zeabusTeam/power_management/circuit/power_distributor.kicad_pcb

## KiCad design circuit/power_distributor.kicad_pcb (2020-04-21)

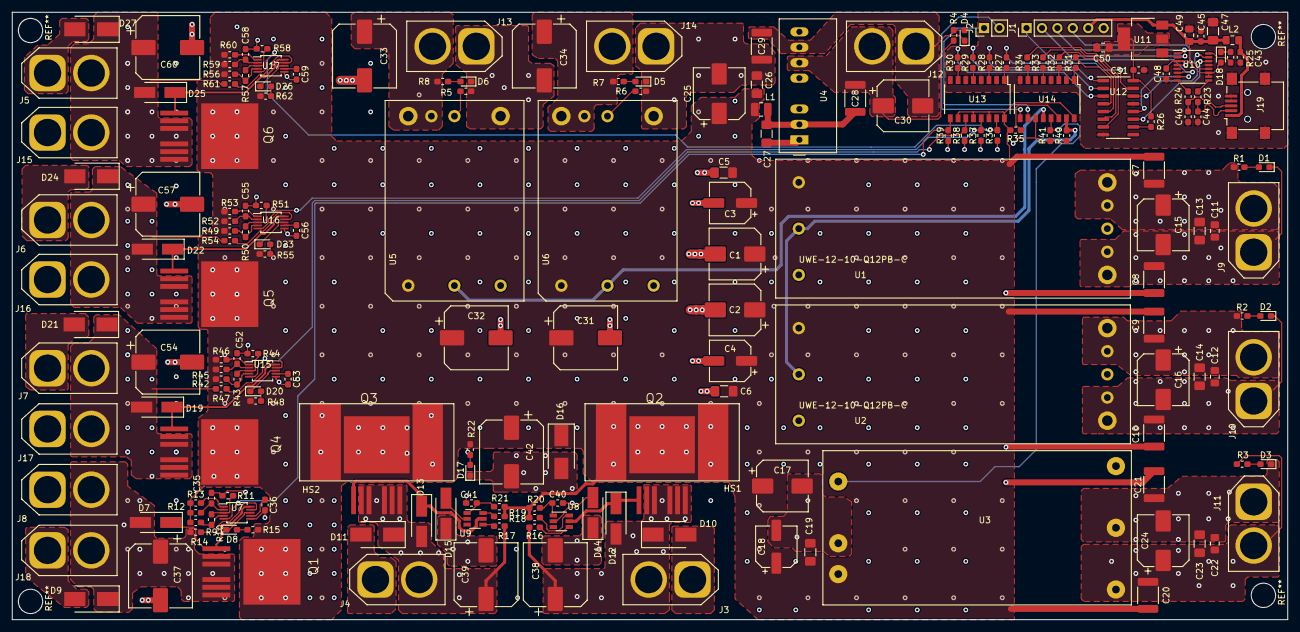
[picture p13: board power_distributor.kicad_pcb from above]

Board: 4 copper layers, 210.0 x 100.0 mm, 195 parts (0 on the bottom side), 119 nets.

Parts:
C1, C2, C15, C16, C17, C24, C25, C30: 100uF; CP_Elec_8x10
C3, C4, C18: 22uF; CP_Elec_6.3x5.8
C5, C6, C13, C14, C19, C23, C26, C27: 10uF; C_1206_3216Metric_Pad1.42x1.75mm_HandSolder
C7, C8, C9, C10, C20, C21, C28, C29: 1000pF,3kV; C_1812_4532Metric_Pad1.30x3.40mm_HandSolder
C11, C12, C22, C49, C50: 1uF; C_0805_2012Metric_Pad1.15x1.40mm_HandSolder
C31, C32, C33, C34, C37, C38, C39, C42, C54, C57, C60: 220uF; CP_Elec_10x10
C35, C40, C41, C45, C48, C51, C52, C55, C58: 0.1uF; C_0603_1608Metric_Pad1.05x0.95mm_HandSolder
C36, C53, C56, C59: 150nF; C_0603_1608Metric_Pad1.05x0.95mm_HandSolder
C43: 0.01uF; C_0603_1608Metric_Pad1.05x0.95mm_HandSolder
C44, C46: 47pF; C_0603_1608Metric_Pad1.05x0.95mm_HandSolder
C47: 4.7uF; C_1206_3216Metric_Pad1.42x1.75mm_HandSolder
D1: 12V_On_1; LED_0603_1608Metric_Pad1.05x0.95mm_HandSolder
D2: 12V_On_2; LED_0603_1608Metric_Pad1.05x0.95mm_HandSolder
D3: 5V_On; LED_0603_1608Metric_Pad1.05x0.95mm_HandSolder
D4: 24V_On; LED_0603_1608Metric_Pad1.05x0.95mm_HandSolder
D5: 8.4V On_2; LED_0603_1608Metric_Pad1.05x0.95mm_HandSolder
D6: 8.4V On_1; LED_0603_1608Metric_Pad1.05x0.95mm_HandSolder
D7, D12, D13, D19, D22, D25: SMAJ17CA; D_SMA_Handsoldering
D8, D20, D23, D26: Thruster_ON; LED_0603_1608Metric_Pad1.05x0.95mm_HandSolder
D9, D10, D11, D16, D21, D24, D27: SMBJ26A; D_SMB_Handsoldering
D14, D15: SS16T3G; D_SMA_Handsoldering
D17: Main On; LED_0603_1608Metric_Pad1.05x0.95mm_HandSolder
D18: USB_On; LED_0603_1608Metric_Pad1.05x0.95mm_HandSolder
HS1, HS2: DA-T263-101E; HeatSink-DA-T263-101E
J1: UART; PinHeader_1x06_P2.54mm_Vertical
J2: Opto_AUX; PinHeader_1x02_P2.54mm_Vertical
J3, J4, J5, J6, J7, J8, J9, J10, J11, J12, J13, J14, J15, J16, J17, J18: AMASS XT60; AMASS_XT60-F_1x02_P7.20mm_Vertical
J19: USB_B_Mini; USB_Mini-B_Lumberg_2486_01_Horizontal
L1: 10uH,1A; L_1008_2520Metric
L2: Ferrite 600R 2A; L_0805_2012Metric_Pad1.15x1.40mm_HandSolder
Q1, Q4, Q5, Q6: AUIRFS8409-7P; D2PAK-7
Q2: IPB009N03LG; D2PAK-7
Q3: IPB009N03L_G; D2PAK-7
R1, R2: 3.6k; R_0603_1608Metric_Pad1.05x0.95mm_HandSolder
R3, R35: 1k; R_0603_1608Metric_Pad1.05x0.95mm_HandSolder
R4: 7.5k; R_0603_1608Metric_Pad1.05x0.95mm_HandSolder
R5, R6, R36, R37, R38, R39, R40, R41: 3.3k; R_0603_1608Metric_Pad1.05x0.95mm_HandSolder
R7, R8: 2.4k; R_0603_1608Metric_Pad1.05x0.95mm_HandSolder
R9, R14, R15, R26, R42, R47, R48, R49, R54, R55, R56, R61, R62: 10k; R_0603_1608Metric_Pad1.05x0.95mm_HandSolder
R10, R43, R50, R57: 160; R_0603_1608Metric_Pad1.05x0.95mm_HandSolder
R11, R44, R51, R58: 1.27k; R_0603_1608Metric_Pad1.05x0.95mm_HandSolder
R12, R20, R21, R45, R52, R59: 100; R_0603_1608Metric_Pad1.05x0.95mm_HandSolder
R13, R46, R53, R60: 8.66k; R_0603_1608Metric_Pad1.05x0.95mm_HandSolder
R16, R17, R18, R19: 0; R_0603_1608Metric_Pad1.05x0.95mm_HandSolder
R22: 5.6k; R_0603_1608Metric_Pad1.05x0.95mm_HandSolder
R23, R24: 27; R_0603_1608Metric_Pad1.05x0.95mm_HandSolder
R25: 270; R_0603_1608Metric_Pad1.05x0.95mm_HandSolder
R27, R28, R29, R30, R31, R32, R33: 200; R_0603_1608Metric_Pad1.05x0.95mm_HandSolder
R34: 220; R_0603_1608Metric_Pad1.05x0.95mm_HandSolder
U1, U2: UWE-12-10-Q12PB-C; UWE-xxxx
U3: UEI30-050-Q12P-C; UEI30
U4: TMR_6-2415WI; Converter_DCDC_TRACO_TMR-xxxx_THT
U5, U6: i6A4W020A033V-001-R; I6A
U7, U15, U16, U17: LM5060; MSOP-10_3x3mm_P0.5mm
U8, U9: LM5050-1; TSOT-23-6
U10: FT230XS; SSOP-16_3.9x4.9mm_P0.635mm
U11: LM1117-3.3; SOT-223-3_TabPin2
U12: 74AHC595D; SOIC-16_3.9x9.9mm_P1.27mm
U13, U14: PS2801C-4; SOP-16_4.4x10.4mm_P1.27mm

Connections:
/Battery_ORing/+BATT: C1.1, C2.1, C3.1, C4.1, C5.1, C6.1, C7.2, C9.2, C17.1, C18.1, C19.1, C20.2, C25.1, C26.1, C31.1, C32.1, C42.1, D16.1, HS1.1, HS2.1, L1.1, Q1.D, Q2.D, Q3.D, Q4.D, Q5.D, Q6.D, R9.1, R12.1, R13.1, R15.1, R18.1, R19.1, R20.1, R21.1, R22.1, R35.2, R42.1, R45.1, R46.1, R48.1, R49.1, R52.1, R53.1, R55.1, R56.1, R59.1, R60.1, R62.1, U1.1, U2.1, U3.1, U5.1, U6.1, U13.10, U13.12, U13.14, U13.16, U14.16
/Battery_ORing/+BATT_1: C38.1, D10.1, D12.2, J3.2, Q2.S, R16.1
/Battery_ORing/+BATT_2: C39.1, D11.1, D13.2, J4.2, Q3.S, R17.1
/DC/DC_conveters/+5V_ISOLATED: C20.1, C22.1, C23.1, C24.1, J11.2, R3.1, U3.4
/DC/DC_conveters/+8.4V_1: C33.1, J13.2, R8.1, U5.7, U5.8
/DC/DC_conveters/+8.4V_2: C34.1, J14.2, R7.1, U6.7, U6.8
/DC/DC_conveters/+12V_ISOLATED_1: C7.1, C11.1, C13.1, C15.1, J9.2, R1.1, U1.7, U1.8
/DC/DC_conveters/+12V_ISOLATED_2: C9.1, C12.1, C14.1, C16.1, J10.2, R2.1, U2.7, U2.8
/DC/DC_conveters/+24V_ISOLATED: C28.1, C30.1, J12.2, R4.1, U4.6
/DC/DC_conveters/EN_5V: R41.2, U3.3, U14.13
/DC/DC_conveters/EN_8.4V: U5.2, U6.2, U14.12
/DC/DC_conveters/EN_12V: R40.2, U1.2, U2.2, U14.15
/DC/DC_conveters/GND_5V_ISOLATED: C21.1, C22.2, C23.2, C24.2, D3.1, J11.1, U3.5
/DC/DC_conveters/GND_12V_ISOLATED_1: C8.1, C11.2, C13.2, C15.2, D1.1, J9.1, U1.4, U1.5
/DC/DC_conveters/GND_12V_ISOLATED_2: C10.1, C12.2, C14.2, C16.2, D2.1, J10.1, U2.4, U2.5
/DC/DC_conveters/GND_24V_ISOLATED: C29.1, C30.2, D4.1, J12.1, U4.7
/Thruster_Switch_1/+Vout: C60.1, D25.2, D27.1, J5.2, J15.2, Q6.S, R61.1
/Thruster_Switch_1/EN: R36.2, U13.15, U17.5
/Thruster_Switch_2/+Vout: C57.1, D22.2, D24.1, J6.2, J16.2, Q5.S, R54.1
/Thruster_Switch_2/EN: R37.2, U13.13, U16.5
/Thruster_Switch_3/+Vout: C54.1, D19.2, D21.1, J7.2, J17.2, Q4.S, R47.1
/Thruster_Switch_3/EN: R38.2, U13.11, U15.5
/Thruster_Switch_4/+Vout: C37.1, D7.2, D9.1, J8.2, J18.2, Q1.S, R14.1
/Thruster_Switch_4/EN: R39.2, U7.5, U13.9
/USB_Interface/D+: C46.1, J19.3, R24.2
/USB_Interface/D-: C44.1, J19.2, R23.2
/USB_Interface/D_M: R23.1, U10.9
/USB_Interface/D_P: R24.1, U10.8
/USB_Interface/OPTO_C: J2.1, U14.10
/USB_Interface/OPTO_E: J2.2, U14.9
/USB_Interface/RXD: J1.4, U10.4
/USB_Interface/TXD: J1.3, U10.1
/USB_Interface/VCCIO: C48.1, D18.2, U10.3, U10.10, U10.11
/USB_Interface/~CTS: J1.1, U10.6
/USB_Interface/~RTS: J1.2, U10.2
GND: C43.2, C44.2, C45.2, C46.2, C47.2, C48.2, C49.2, C50.2, C51.2, J1.6, J19.4, J19.5, J19.6, U10.5, U10.13, U11.1, U12.8, U12.13, U13.2, U13.4, U13.6, U13.8, U14.2, U14.4, U14.6, U14.8
GNDPWR: C1.2, C2.2, C3.2, C4.2, C5.2, C6.2, C8.2, C10.2, C17.2, C18.2, C19.2, C21.2, C25.2, C26.2, C27.2, C29.2, C31.2, C32.2, C33.2, C34.2, C35.2, C36.2, C37.2, C38.2, C39.2, C40.2, C41.2, C42.2, C52.2, C53.2, C54.2, C55.2, C56.2, C57.2, C58.2, C59.2, C60.2, D5.1, D6.1, D9.2, D10.2, D11.2, D14.1, D15.1, D16.2, D17.1, D21.2, D24.2, D27.2, J3.1, J4.1, J5.1, J6.1, J7.1, J8.1, J13.1, J14.1, J15.1, J16.1, J17.1, J18.1, R5.1, R6.1, R11.2, R36.1, R37.1, R38.1, R39.1, R40.1, R41.1, R44.2, R51.2, R58.2, U1.3, U2.3, U3.2, U4.1, U5.3, U5.4, U6.3, U6.4, U7.6, U14.11, U15.6, U16.6, U17.6
unnamed: C27.1, C28.2, L1.2, U4.2
unnamed: C35.1, R12.2, U7.2
unnamed: C36.1, U7.7
unnamed: C40.1, R20.2, U8.1
unnamed: C41.1, R21.2, U9.1
unnamed: C43.1, J19.1, L2.1
unnamed: C50.1, C51.1, R26.2, U11.2, U12.16
unnamed: C52.1, R45.2, U15.2
unnamed: C53.1, U15.7
unnamed: C55.1, R52.2, U16.2
unnamed: C56.1, U16.7
unnamed: C58.1, R59.2, U17.2
unnamed: C59.1, U17.7
unnamed: D1.2, R1.2
unnamed: D2.2, R2.2
unnamed: D3.2, R3.2
unnamed: D4.2, R4.2
unnamed: D5.2, R7.2
unnamed: D6.2, R8.2
unnamed: D7.1, Q1.G, U7.10
unnamed: D8.1, U7.8
unnamed: D8.2, R15.2
unnamed: D12.1, Q2.G, U8.5
unnamed: D13.1, Q3.G, U9.5
unnamed: D14.2, U8.2
unnamed: D15.2, U9.2
unnamed: D17.2, R22.2
unnamed: D18.1, R25.2
unnamed: D19.1, Q4.G, U15.10
unnamed: D20.1, U15.8
unnamed: D20.2, R48.2
unnamed: D22.1, Q5.G, U16.10
unnamed: D23.1, U16.8
unnamed: D23.2, R55.2
unnamed: D25.1, Q6.G, U17.10
unnamed: D26.1, U17.8
unnamed: D26.2, R62.2
unnamed: R5.2, U5.6
unnamed: R6.2, U6.6
unnamed: R9.2, R10.1, U7.4
unnamed: R10.2, R11.1, U7.3
unnamed: R13.2, U7.1
unnamed: R14.2, U7.9
unnamed: R16.2, U8.4
unnamed: R17.2, U9.4
unnamed: R18.2, U8.6
unnamed: R19.2, U9.6
unnamed: R25.1, U10.16
unnamed: R26.1, U12.10
unnamed: R27.1, U13.1
unnamed: R27.2, U12.15
unnamed: R28.1, U13.3
unnamed: R28.2, U12.1
unnamed: R29.1, U13.5
unnamed: R29.2, U12.2
unnamed: R30.1, U13.7
unnamed: R30.2, U12.3
unnamed: R31.1, U14.1
unnamed: R31.2, U12.4
unnamed: R32.1, U14.3
unnamed: R32.2, U12.5
unnamed: R33.1, U14.5
unnamed: R33.2, U12.6
unnamed: R34.1, U14.7
unnamed: R34.2, U12.7
unnamed: R35.1, U14.14
unnamed: R42.2, R43.1, U15.4
unnamed: R43.2, R44.1, U15.3
unnamed: R46.2, U15.1
unnamed: R47.2, U15.9
unnamed: R49.2, R50.1, U16.4
unnamed: R50.2, R51.1, U16.3
unnamed: R53.2, U16.1
unnamed: R54.2, U16.9
unnamed: R56.2, R57.1, U17.4
unnamed: R57.2, R58.1, U17.3
unnamed: R60.2, U17.1
unnamed: R61.2, U17.9
unnamed: U10.7, U12.12
unnamed: U10.14, U12.11
unnamed: U10.15, U12.14
VBUS: C45.1, C47.1, C49.1, J1.5, L2.2, U10.12, U11.3
