zeabusTeam/power_management/(commit log)

2020-03-28 (Real) Initial commit
    This is the initial commit fter gathering file from Dome
    [battery_oring.sch, dc_dc_convert_8v4.sch, dc_dc_converter.sch, dc_dc_converter_12v.sch, dc_dc_converter_24v.sch, dc_dc_converter_5v.sch, load_switch.sch, power_distributor.kicad_pcb]
2020-03-29 Finish schematic. Ready for footprint assignment
    Finish the first version of schematic.
    [battery_oring.sch, dc_dc_convert_8v4.sch, dc_dc_converter.sch, dc_dc_converter_12v.sch, dc_dc_converter_24v.sch, dc_dc_converter_5v.sch, load_switch.sch, power_distributor.sch]
2020-03-30 Finsh annotation and footprint assignment
    [battery_oring.sch, dc_dc_convert_8v4.sch, dc_dc_converter_12v.sch, dc_dc_converter_24v.sch, dc_dc_converter_5v.sch, load_switch.sch, power_distributor.sch, usb_interface.sch]
2020-03-31 Remove redundant protection. Finish lay-out. Also, generated BOM
    [battery_oring.sch, load_switch.sch, power_distributor.kicad_pcb, usb_interface.sch]
2020-04-04 Place all electrical planes and plane vias
    [power_distributor.kicad_pcb]
2020-04-07 Complete all PCB routing.
    [battery_oring.sch, dc_dc_convert_8v4.sch, dc_dc_converter.sch, dc_dc_converter_12v.sch, dc_dc_converter_24v.sch, dc_dc_converter_5v.sch, load_switch.sch, power_distributor.kicad_pcb]
2020-04-20 Add VBUS output to RS232 connector
    [load_switch.sch, power_distributor.kicad_pcb, power_distributor.sch]
2020-04-21 Change LDO to LM1117-3.3
    [power_distributor.kicad_pcb, usb_interface.sch]
2022-07-21 Update to Kicad6
    [battery_oring.kicad_sch, dc_dc_convert_8v4.kicad_sch, dc_dc_converter.kicad_sch, dc_dc_converter_12v.kicad_sch, dc_dc_converter_24v.kicad_sch, dc_dc_converter_5v.kicad_sch, load_switch.kicad_sch, power_distributor.kicad_sch]
